GuillermoDuarte888/MecaChess-Robotic-Arm/Imagenes/Brazo Robot diseño completo.png

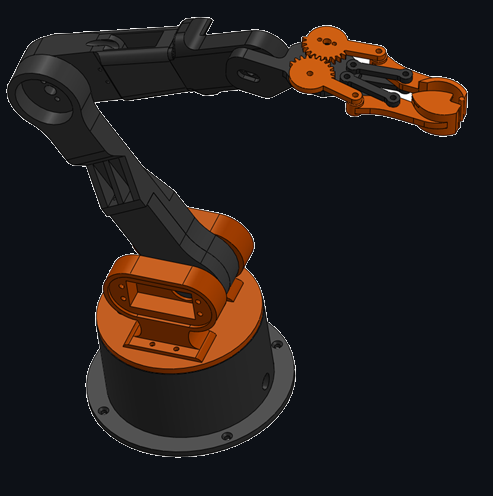
Imagenes/Brazo Robot diseño completo.png
