GuillermoDuarte888/MecaChess-Robotic-Arm/Imagenes/brazo robot.jpg

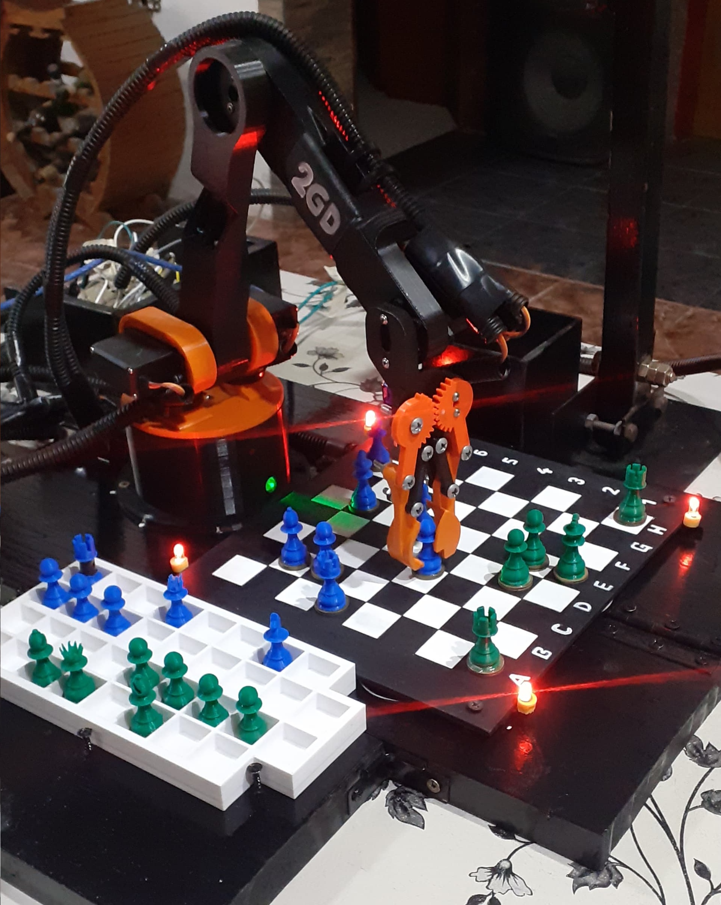
Imagenes/brazo robot.jpg
