GuillermoDuarte888/MecaChess-Robotic-Arm/Imagenes/Cinematica Directa e Inversa.png

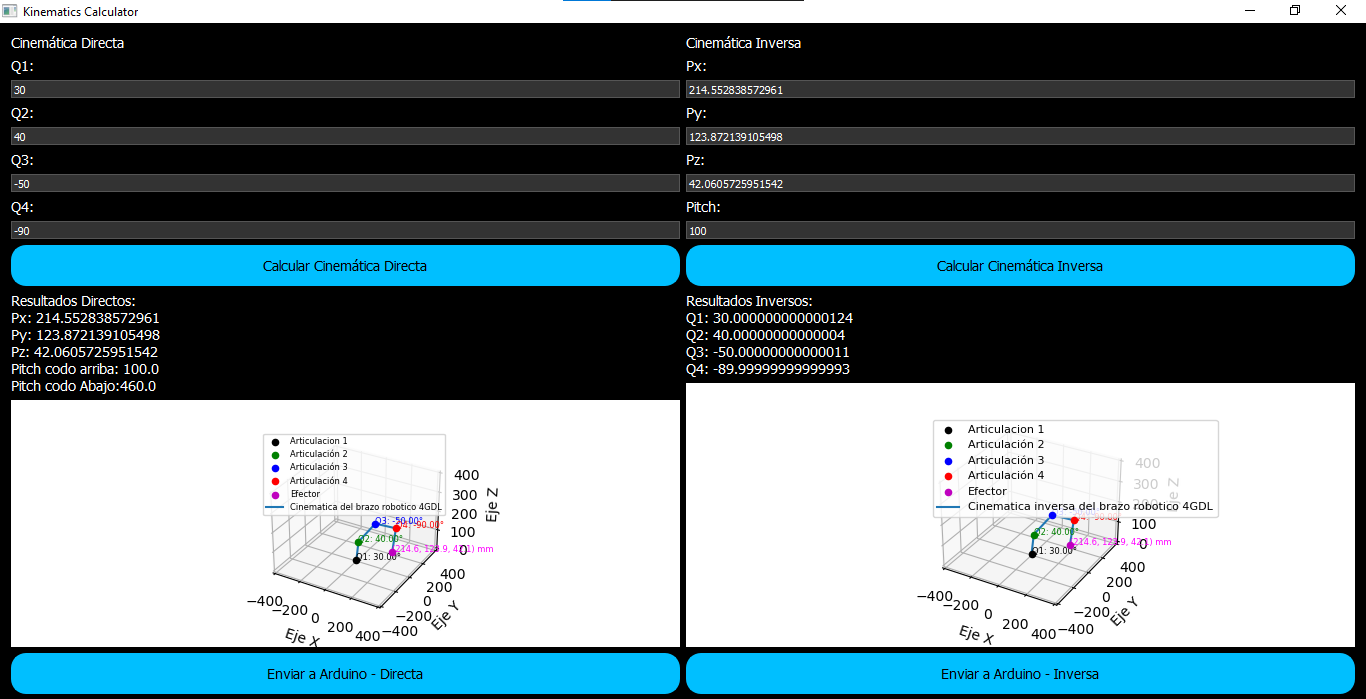
Imagenes/Cinematica Directa e Inversa.png
