GuillermoDuarte888/MecaChess-Robotic-Arm/Imagenes/Cinematica Directa simulacion.png

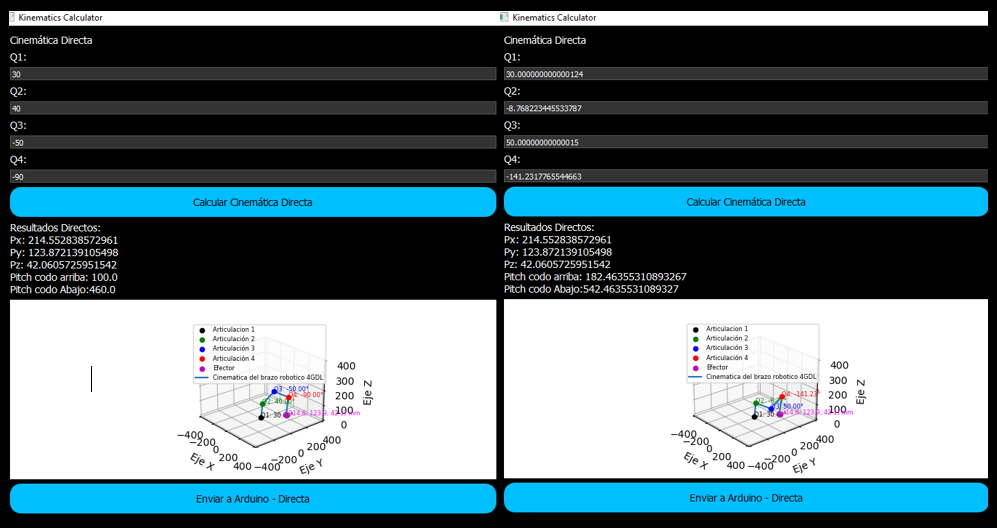
Imagenes/Cinematica Directa simulacion.png
