GuillermoDuarte888/MecaChess-Robotic-Arm/Imagenes/Interfaz.png

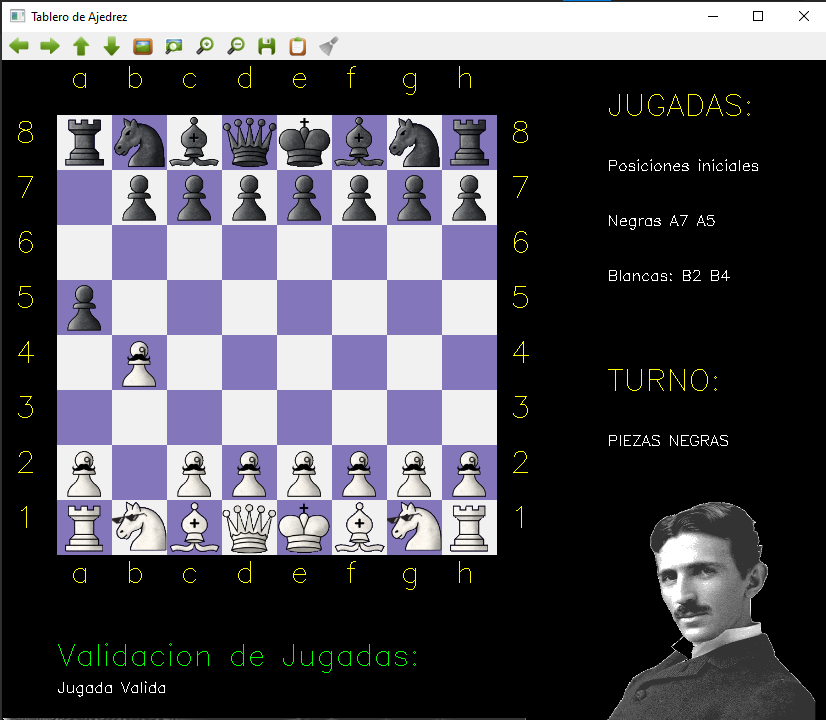
Imagenes/Interfaz.png
